TraxNet/AstroPiCompute2/astro_compute_board.jpg

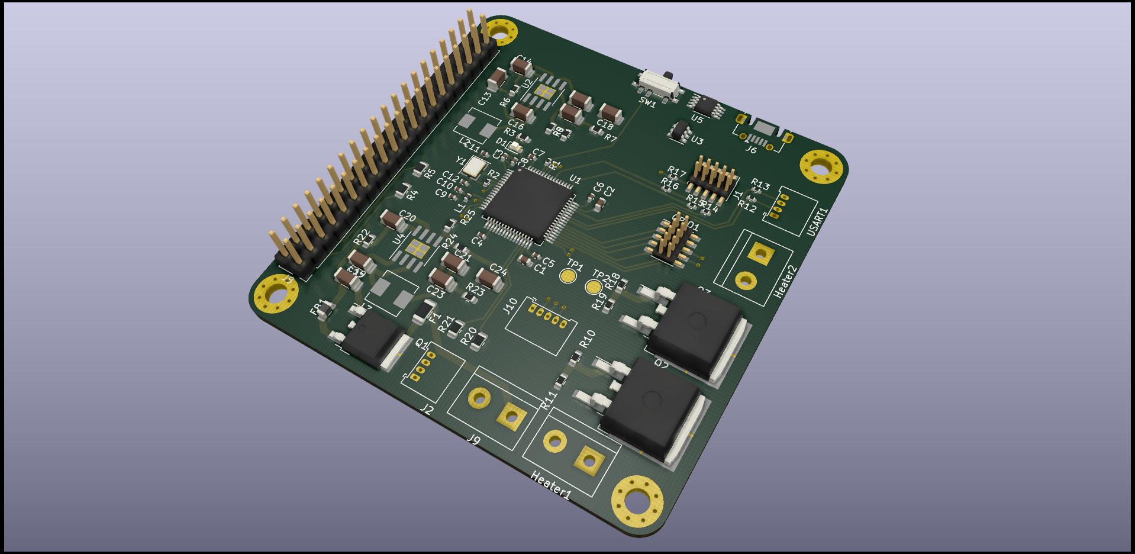
astro_compute_board.jpg
