TraxNet/AstroPiCompute2/jlcpcb_parts.txt

MOTOR Driver: TB6612FNG(O,C,8,EL
SMD CRYSTAL RESONATORS 16MHZ ±10PPM SMD-3225_4P ROHS Basic Part: X322516MLB4SI
DC-DC CONVERTERS STEP-DOWN ADJUSTABLE 1 4.5V 18V 0.8V 12V 3A SOIC-8_EP_150MIL ROHS Extended Part: RT7257BHZSP
P-CHANNEL 30V 19A 3V @ 250UA 50MΩ @ 10A,10V 30W TO-252-2(DPAK) MOSFET ROHS Extended Part: SE20P03
SCHOTTKY BARRIER DIODES (SBD) SOD-323 ROHS: PSBD3D40V1H
DIODES - ESD SOT-23-6 ROHS: USBLC6-2SC6
TO263 MOSFET ROHS: IRF540NSTRPBF
