TraxNet/AstroPiCompute2/heater_block_model.asc

D1: LED
M1: nmos; PMOS
R1: res; 1k
R2: res; 220k
R3: res; 100
R4: res; 1k
V1: voltage; SINE(0 3.3 100)
V2: voltage; 12v
Named nets: 0
.tran 0.5s
