TraxNet/AstroPiCompute2/astro_compute_board.kicad_pcb

## KiCad design astro_compute_board.kicad_pcb (2021-04-17)

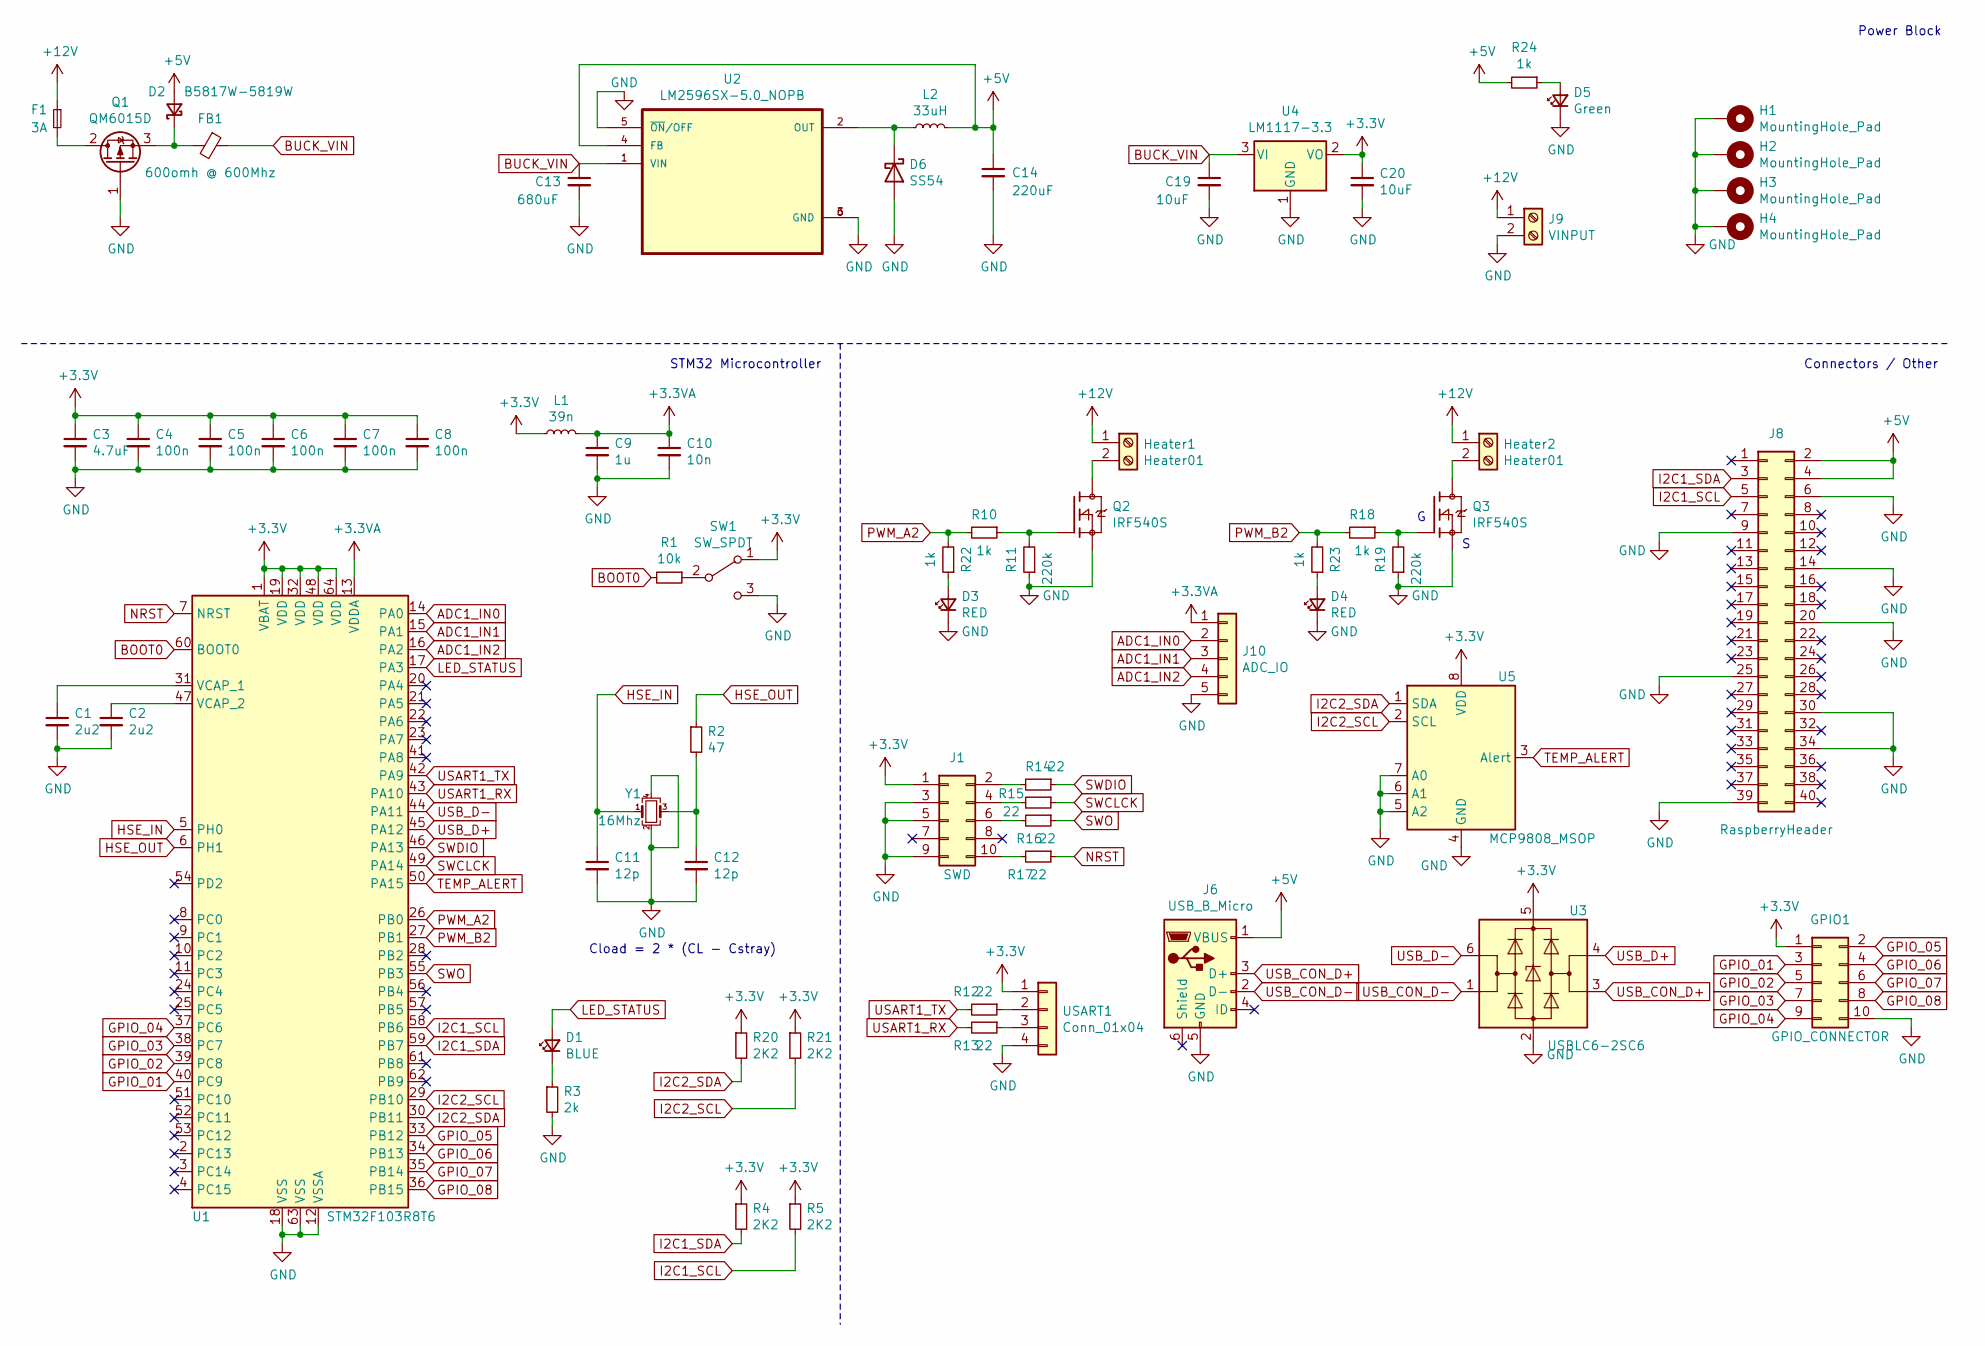
[picture p2: schematic astro_compute_board.sch, Astro Compute Raspberry Pi + STM32]

Parts:
C1, C2: 2u2; C_0603_1608Metric; LCSC Part # C23630
C3: 4.7uF; C_0402_1005Metric; LCSC Part # C23733
C4, C5, C6, C7, C8: 100n; C_0402_1005Metric; LCSC Part # C1525
C9: 1u; C_0402_1005Metric; LCSC Part # C52923
C10: 10n; C_0402_1005Metric; LCSC Part # C15195
C11, C12: 12p; C_0402_1005Metric; LCSC Part # C1547
C13: 680uF; CP_Radial_D8.0mm_P3.50mm; LCSC Part # C13585
C14: 220uF; CP_Radial_D6.3mm_P2.50mm; LCSC Part # C13585
C19, C20: 10uF; C_1206_3216Metric; LCSC Part # C13585
D1: BLUE; LED_0603_1608Metric; LCSC Part # C72041
D2: B5817W-5819W; D_SOD-123; LCSC Part # C8598
D3, D4: RED; LED_0603_1608Metric; LCSC Part # C2286
D5: Green; LED_0603_1608Metric; LCSC Part # C72043
D6: SS54; D_SMA; LCSC Part # C22452
F1: 3A; Fuse_1206_3216Metric
FB1: 600omh @ 600Mhz; L_0805_2012Metric; LCSC Part # C1017
GPIO1: GPIO_CONNECTOR; PinHeader_2x05_P1.27mm_Vertical_SMD
H1, H2, H3, H4: MountingHole_Pad; MountingHole_3.2mm_M3_Pad_Via
Heater1, Heater2: Heater01; TerminalBlock_bornier-2_P5.08mm
J1: SWD; PinHeader_2x05_P1.27mm_Vertical_SMD
J6: USB_B_Micro; USB_Micro-B_Molex-105017-0001; LCSC Part # C404969
J8: RaspberryHeader; PinHeader_2x20_P2.54mm_Vertical
J9: VINPUT; TerminalBlock_bornier-2_P5.08mm
J10: ADC_IO; Molex_PicoBlade_53048-0510_1x05_P1.25mm_Horizontal
L1: 39n; L_0402_1005Metric; LCSC Part # C26443
L2: 33uH; L_Radial_D7.5mm_P3.50mm_Fastron_07P
Q1: QM6015D; TO-252-2; LCSC Part # C238708
Q2, Q3: IRF540S; TO-263-2; PARTREV B; LCSC Part # C725068
R1: 10k; R_0402_1005Metric; LCSC Part # C25744
R2: 47; R_0402_1005Metric; LCSC Part # C25118
R3: 2k; R_0603_1608Metric; LCSC Part # C22975
R4, R5, R20, R21: 2K2; R_0805_2012Metric; LCSC Part # C17520
R10, R18, R22, R23, R24: 1k; R_0603_1608Metric; LCSC Part # C21190
R11, R19: 220k; R_0603_1608Metric; LCSC Part # C22961
R12, R13, R14, R15, R16, R17: 22; R_0402_1005Metric; LCSC Part # C25092
SW1: SW_SPDT; SW_SPDT_PCM12; LCSC Part # C431541
U1: STM32F103R8T6; LQFP-64_10x10mm_P0.5mm; LCSC Part # C46034
U2: LM2596SX-5.0_NOPB; NOPB; LCSC Part # C10002
U3: USBLC6-2SC6; SOT-23-6; LCSC Part # C7519
U4: LM1117-3.3; SOT-223; LCSC Part # C23984
U5: MCP9808_MSOP; MSOP-8_3x3mm_P0.65mm; LCSC Part # C129490
USART1: Conn_01x04; Molex_PicoBlade_53048-0410_1x04_P1.25mm_Horizontal
Y1: 16Mhz; Crystal_SMD_3225-4Pin_3.2x2.5mm; LCSC Part # C13738

Connections:
+3.3VA: C9.1, C10.1, J10.1, L1.2, U1.13 (VDDA)
+3V3: C3.1, C4.1, C5.1, C6.1, C7.1, C8.1, C20.1, GPIO1.1, J1.1, L1.1, R4.1, R5.1, R20.1, R21.1, SW1.1 (A), U1.1 (VBAT), U1.19 (VDD), U1.32 (VDD), U1.48 (VDD), U1.64 (VDD), U3.5 (VBUS), U4.2 (VO), U5.8 (VDD), USART1.1
+5V: C14.1, D2.2 (A), J6.1 (VBUS), J8.2, J8.4, L2.2, R24.2, U2.4 (FB)
+12V: F1.1, Heater1.1, Heater2.1, J9.1
ADC1_IN0: J10.2, U1.14 (PA0)
ADC1_IN1: J10.3, U1.15 (PA1)
ADC1_IN2: J10.4, U1.16 (PA2)
BOOT0: R1.2, U1.60 (BOOT0)
BUCK_VIN: C13.1, C19.1, FB1.1, U2.1 (VIN), U4.3 (VI)
GND: C1.2, C2.2, C3.2, C4.2, C5.2, C6.2, C7.2, C8.2, C9.2, C10.2, C11.2, C12.2, C13.2, C14.2, C19.2, C20.2, D3.1 (K), D4.1 (K), D5.1 (K), D6.2 (A), GPIO1.10, H1.1, H2.1, H3.1, H4.1, J1.3, J1.5, J1.9, J6.5 (GND), J8.6, J8.9, J8.14, J8.20, J8.25, J8.30, J8.34, J8.39, J9.2, J10.5, Q1.1 (G), Q2.3, Q3.3, R3.2, R11.1, R19.1, SW1.3 (C), U1.12 (VSSA), U1.18 (VSS), U1.63 (VSS), U2.3 (GND), U2.5 (~ON~/OFF), U2.6 (GND), U3.2 (GND), U4.1 (GND), U5.4 (GND), U5.5 (A2), U5.6 (A1), U5.7 (A0), USART1.4, Y1.2, Y1.4
GPIO_01: GPIO1.3, U1.40 (PC9)
GPIO_02: GPIO1.5, U1.39 (PC8)
GPIO_03: GPIO1.7, U1.38 (PC7)
GPIO_04: GPIO1.9, U1.37 (PC6)
GPIO_05: GPIO1.2, U1.33 (PB12)
GPIO_06: GPIO1.4, U1.34 (PB13)
GPIO_07: GPIO1.6, U1.35 (PB14)
GPIO_08: GPIO1.8, U1.36 (PB15)
HSE_IN: C11.1, U1.5 (PH0), Y1.1
HSE_OUT: R2.1, U1.6 (PH1)
I2C1_SCL: J8.5, R5.2, U1.58 (PB6)
I2C1_SDA: J8.3, R4.2, U1.59 (PB7)
I2C2_SCL: R21.2, U1.29 (PB10), U5.2 (SCL)
I2C2_SDA: R20.2, U1.30 (PB11), U5.1 (SDA)
LED_STATUS: D1.2 (A), U1.17 (PA3)
NRST: R17.1, U1.7 (NRST)
unnamed: C1.1, U1.31 (VCAP_1)
unnamed: C2.1, U1.47 (VCAP_2)
unnamed: C12.1, R2.2, Y1.3
unnamed: D1.1 (K), R3.1
unnamed: D2.1 (K), FB1.2, Q1.3 (S)
unnamed: D3.2 (A), R22.1
unnamed: D4.2 (A), R23.1
unnamed: D5.2 (A), R24.1
unnamed: D6.1 (K), L2.1, U2.2 (OUT)
unnamed: F1.2, Q1.2 (D)
unnamed: Heater1.2, Q2.2
unnamed: Heater2.2, Q3.2
unnamed: J1.2, R14.2
unnamed: J1.4, R15.2
unnamed: J1.6, R16.2
unnamed: J1.10, R17.2
unnamed: Q2.1, R10.1, R11.2
unnamed: Q3.1, R18.1, R19.2
unnamed: R1.1, SW1.2 (B)
unnamed: R12.1, USART1.2
unnamed: R13.1, USART1.3
PWM_A2: R10.2, R22.2, U1.26 (PB0)
PWM_B2: R18.2, R23.2, U1.27 (PB1)
SWCLCK: R15.1, U1.49 (PA14)
SWDIO: R14.1, U1.46 (PA13)
SWO: R16.1, U1.55 (PB3)
TEMP_ALERT: U1.50 (PA15), U5.3 (Alert)
USART1_RX: R13.2, U1.43 (PA10)
USART1_TX: R12.2, U1.42 (PA9)
USB_CON_D+: J6.3 (D+), U3.3 (I/O2)
USB_CON_D-: J6.2 (D-), U3.1 (I/O1)
USB_D+: U1.45 (PA12), U3.4 (I/O2)
USB_D-: U1.44 (PA11), U3.6 (I/O1)

Notes on the sheet:
Cload = 2 * (CL - Cstray)
STM32 Microcontroller
Power Block
Connectors / Other

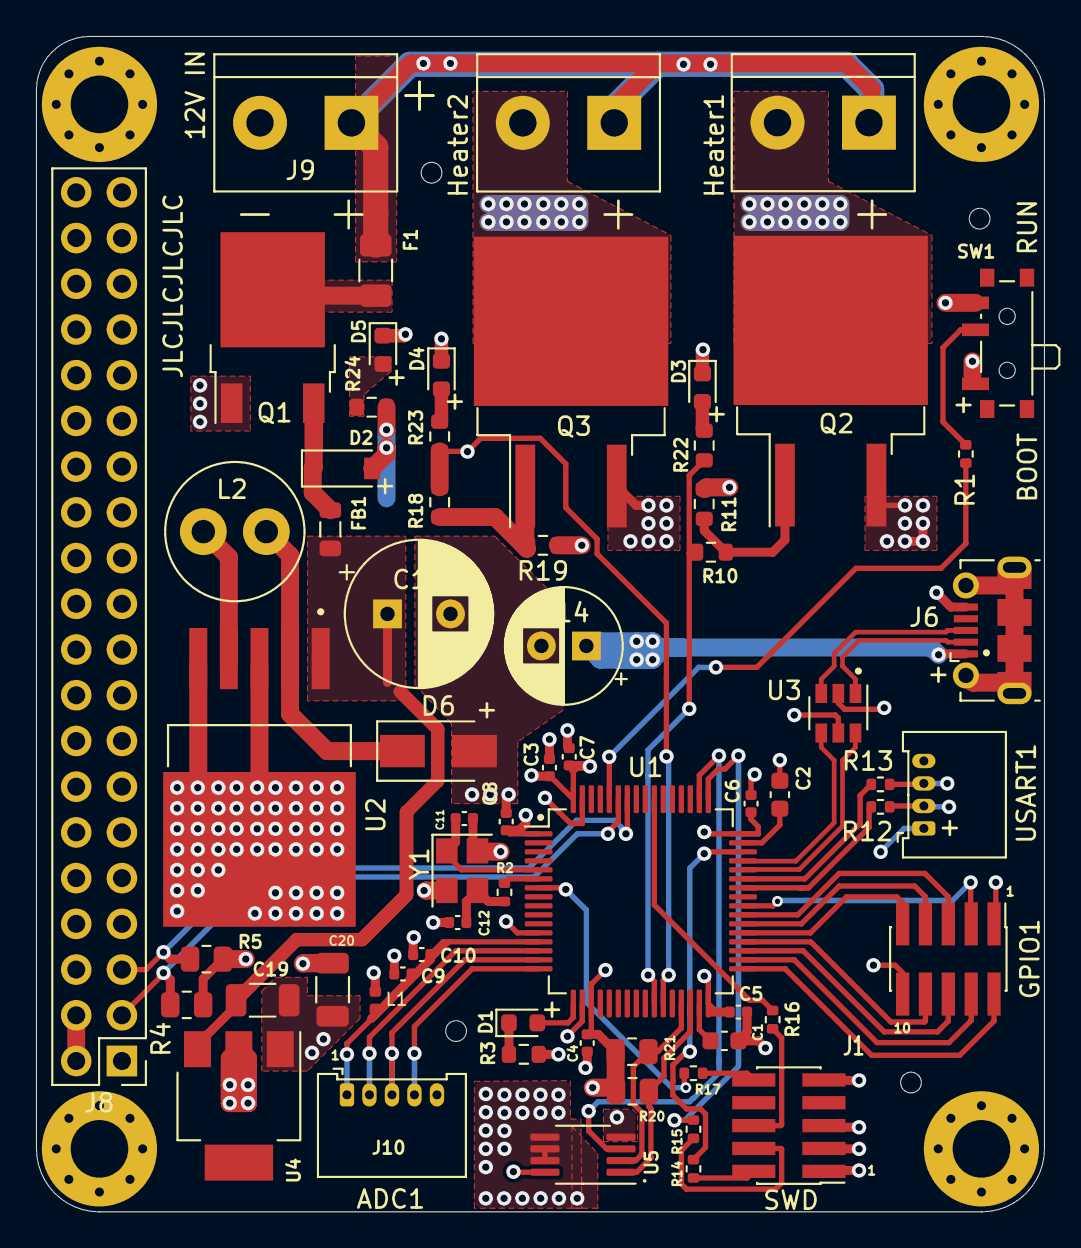
[picture p3: board astro_compute_board.kicad_pcb from above]

Board: 4 copper layers, 56.0 x 65.3 mm, 69 parts (0 on the bottom side), 59 nets.
