TraxNet/AstroPiCompute2/STM32/STM32.ioc

Mcu.UserName=STM32F103R8Tx
PA0-WKUP.Signal=ADCx_IN0
PA1.Signal=ADCx_IN1
PA10.Signal=USART1_RX
PA11.Signal=USB_DM
PA12.Signal=USB_DP
PA13.Signal=SYS_JTMS-SWDIO
PA2.Signal=ADCx_IN2
PA9.Signal=USART1_TX
PB10.Signal=I2C2_SCL
PB11.Signal=I2C2_SDA
PB12.Signal=GPIO_Input
PB13.Signal=GPIO_Input
PB14.Signal=GPIO_Input
PB15.Signal=GPIO_Input
PC6.Signal=GPIO_Input
PC7.Signal=GPIO_Input
PC8.Signal=GPIO_Input
PC9.Signal=GPIO_Input
