TraxNet/AstroPiCompute2/(commit log)

2020-11-20 Initial Repo Commit
    All m ain components in schematic
    [astro_compute_board.kicad_pcb, astro_compute_board.sch]
2020-11-22 Board almost done. Major simplifications ahead
    [astro_compute_board.sch]
2020-11-24 JLCPCB Ready (but costly)
    Contains many extender parts that make PCB expensive.
    [astro_compute_board-B_Cu.gbr, astro_compute_board-B_Mask.gbr, astro_compute_board-B_Paste.gbr, astro_compute_board-B_SilkS.gbr, astro_compute_board-Edge_Cuts.gbr, astro_compute_board-F_Cu.gbr, astro_compute_board-F_Mask.gbr, astro_compute_board-F_Paste.gbr]
2021-04-12 Rev2 - Out of Stock componets update (JLCPCB)
    [astro_compute_board-B_Cu.gbr, astro_compute_board-B_Mask.gbr, astro_compute_board-B_Paste.gbr, astro_compute_board-B_SilkS.gbr, astro_compute_board-Edge_Cuts.gbr, astro_compute_board-F_Cu.gbr, astro_compute_board-F_Mask.gbr, astro_compute_board-F_Paste.gbr]
2021-04-13 Rev2.1 - Redesigned using Bulk Coverter and TH componets for easy testing
    [astro_compute_board.kicad_pcb, astro_compute_board.sch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]
2021-04-17 Minor clean-ups
    [astro_compute_board.kicad_pcb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]
